gabrielogregorio/tic-tac-toe-eletronic/modelo 3D/Imagens/img3.png

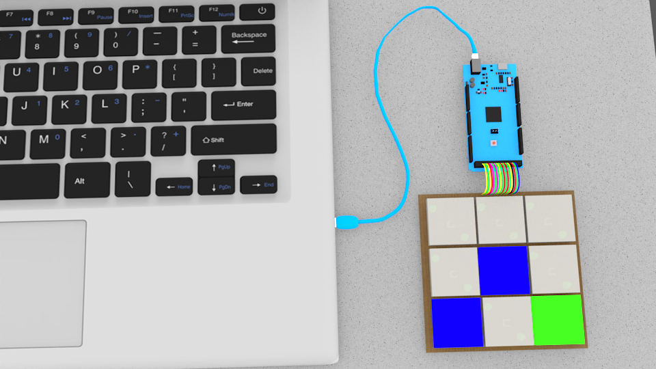
modelo 3D/Imagens/img3.png
