gabrielogregorio/tic-tac-toe-eletronic/modelo 3D/Imagens/img4.png

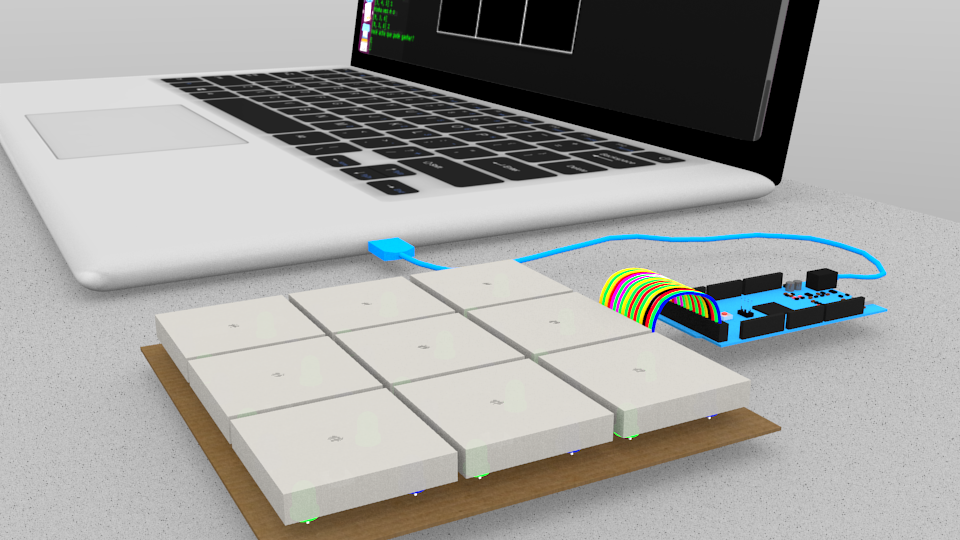
modelo 3D/Imagens/img4.png
