gabrielogregorio/tic-tac-toe-eletronic/modelo 3D/Imagens/img5.png

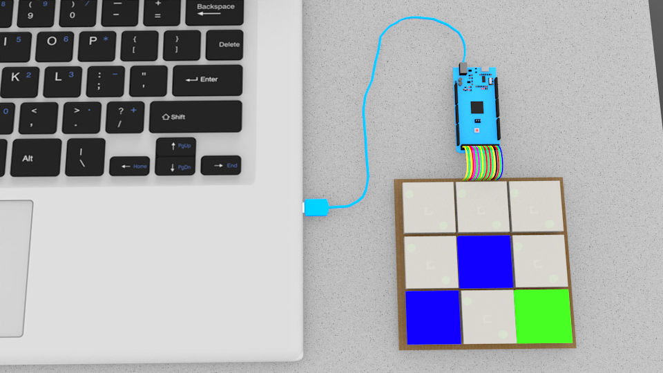
modelo 3D/Imagens/img5.png
