gabrielogregorio/tic-tac-toe-eletronic/modelo 3D/Imagens/madeira.jpg

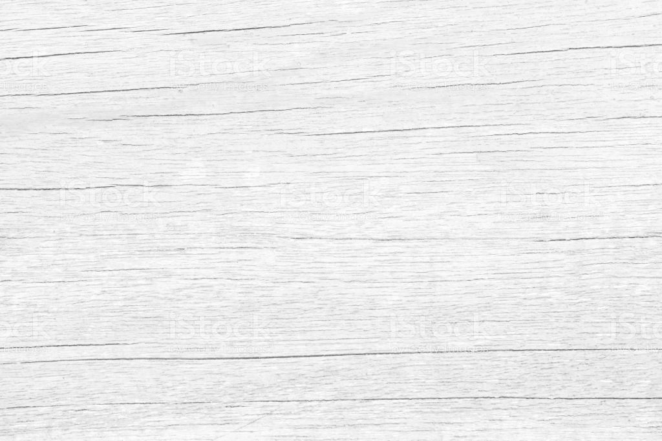
modelo 3D/Imagens/madeira.jpg
