gabrielogregorio/tic-tac-toe-eletronic/modelo 3D/Imagens/teclado.jpg

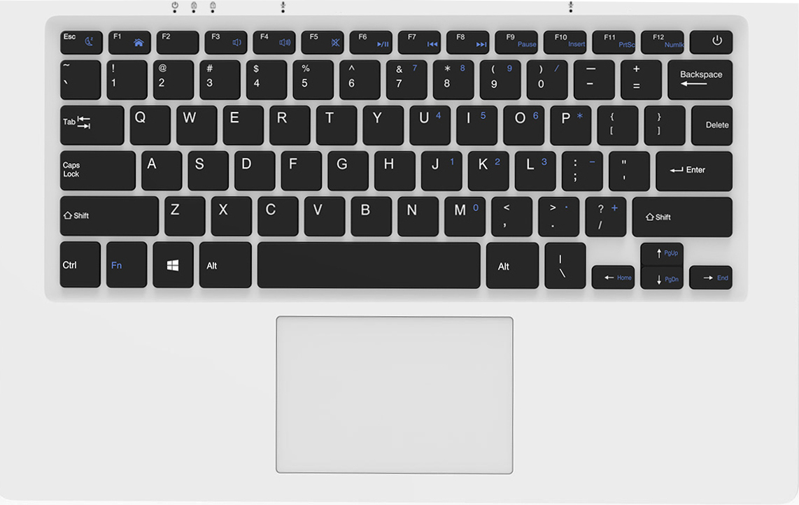
modelo 3D/Imagens/teclado.jpg
