gabrielogregorio/tic-tac-toe-eletronic/modelo 3D/Imagens/print.png

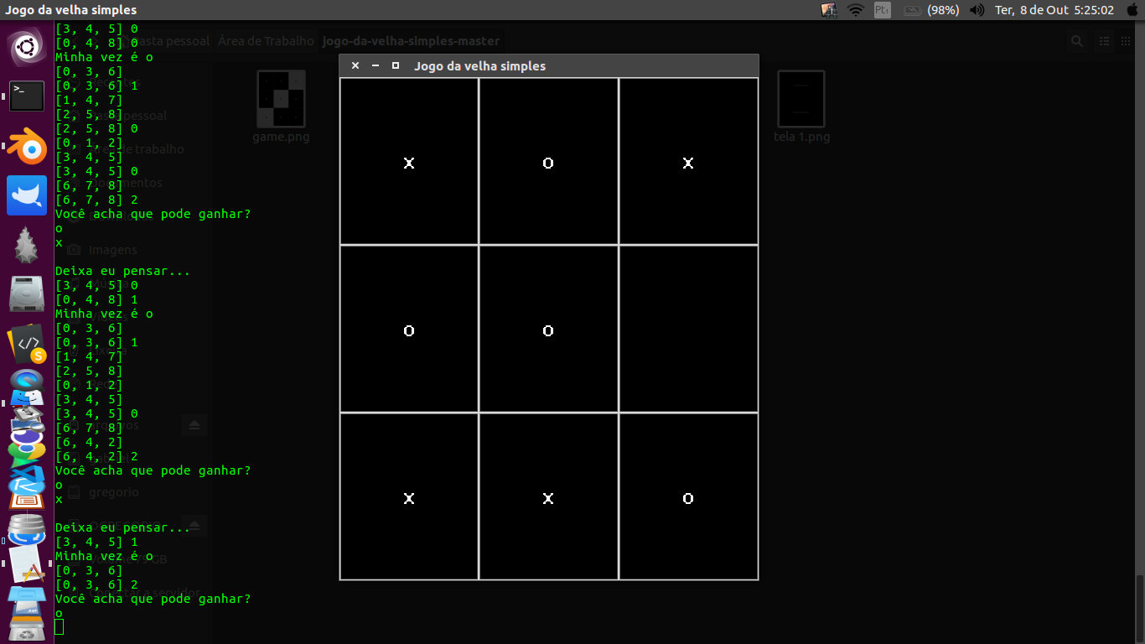
modelo 3D/Imagens/print.png
