gabrielogregorio/tic-tac-toe-eletronic/codigo_do_arduino.ino

/*
  Projeto para a Fatec Aberta em Araçatuba
  Análise e Desenvolvimento de Sistemas
  Desenvolvido por: Equipe Pseudo Geeks
  Fabiano Silva | Fernando Bergamasco | Gabriel Gregorio
*/

// Declaração de variáveis
// Definindo o número dos pinos dos LEDs

const int greenLED1 = 22;
const int blueLED1 = 23;

const int greenLED2 = 24;
const int blueLED2 = 25;

const int greenLED3 = 26;
const int blueLED3 = 27;

const int greenLED4 = 28;
const int blueLED4 = 29;

const int greenLED5 = 30;
const int blueLED5 = 31;

const int greenLED6 = 32;
const int blueLED6 = 33;

const int greenLED7 = 34;
const int blueLED7 = 35;

const int greenLED8 = 36;
const int blueLED8 = 37;

const int greenLED9 = 38;
const int blueLED9 = 39;

// Definindo o número dos pinhos dos pushButtons
const int pushButton1 = 2;
const int pushButton2 = 3;
const int pushButton3 = 4;
const int pushButton4 = 5;
const int pushButton5 = 6;
const int pushButton6 = 7;
const int pushButton7 = 8;
const int pushButton8 = 9;
const int pushButton9 = 10;

// Definindo o estado inicial dos pushButtons
int pushButtonState1 = 0;
int pushButtonState2 = 0;
int pushButtonState3 = 0;
int pushButtonState4 = 0;
int pushButtonState5 = 0;
int pushButtonState6 = 0;
int pushButtonState7 = 0;
int pushButtonState8 = 0;
int pushButtonState9 = 0;

void setup ()
{
  // Iniciando a porta serial
  Serial.begin(9600);

  // Definindo os pinos dos LEDs como OUTPUT
  pinMode(greenLED1,   OUTPUT);
  pinMode(blueLED1,    OUTPUT);
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
  {
    digitalWrite(greenLED9, HIGH);
  }
  else if (inputSignal == 'r')
  {
    digitalWrite(blueLED9, HIGH);
  }
  else if (inputSignal == 'z')
  {
    digitalWrite(greenLED1, LOW);
    digitalWrite(blueLED1, LOW);

    digitalWrite(greenLED2, LOW);
    digitalWrite(blueLED2, LOW);

    digitalWrite(greenLED3, LOW);
    digitalWrite(blueLED3, LOW);

    digitalWrite(greenLED4, LOW);
    digitalWrite(blueLED4, LOW);

    digitalWrite(greenLED5, LOW);
    digitalWrite(blueLED5, LOW);

    digitalWrite(greenLED6, LOW);
    digitalWrite(blueLED6, LOW);

    digitalWrite(greenLED7, LOW);
    digitalWrite(blueLED7, LOW);

    digitalWrite(greenLED8, LOW);
    digitalWrite(blueLED8, LOW);

    digitalWrite(greenLED9, LOW);
    digitalWrite(blueLED9, LOW);
  }
}
